budiand/PlantCare/README.md

# PlantCare
An automatic plant watering system that displays the moisture of the soil and the temperature of room. 
For a detailed explanation check my [wiki page](https://ocw.cs.pub.ro/courses/pm/prj2024/alucaci/andreea.budulan).
