budiand/PlantCare/PlantCare_schema_bloc.png

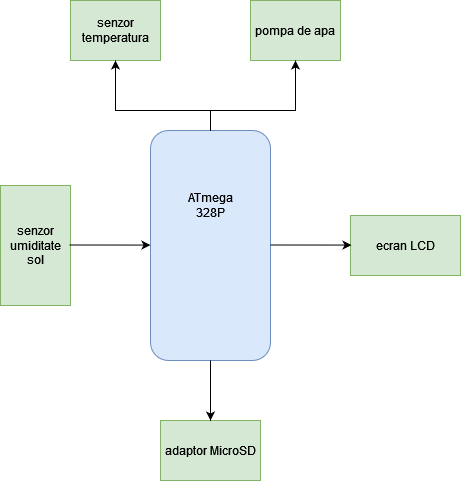
PlantCare_schema_bloc.png
