budiand/PlantCare/SCHEMATIC_PC.png

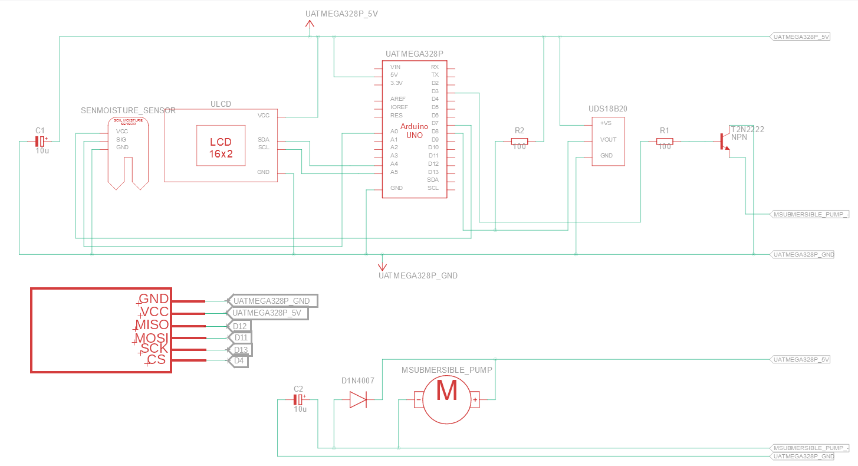
SCHEMATIC_PC.png
