budiand/PlantCare/PlantCare_final/characters.h

// defined characters to use for printing

byte plant[8] = {
  0b00000,
  0b00100,
  0b01010,
  0b00100,
  0b00110,
  0b01100,
  0b00100,
  0b00100
};

byte circle[8] = {
  0b01000,
  0b10100,
  0b01000,
  0b00000,
  0b00000,
  0b00000,
  0b00000,
  0b00000
};
